folk-lab/RTA-Temperature-Controller/RTA TC diagram v2.pdf

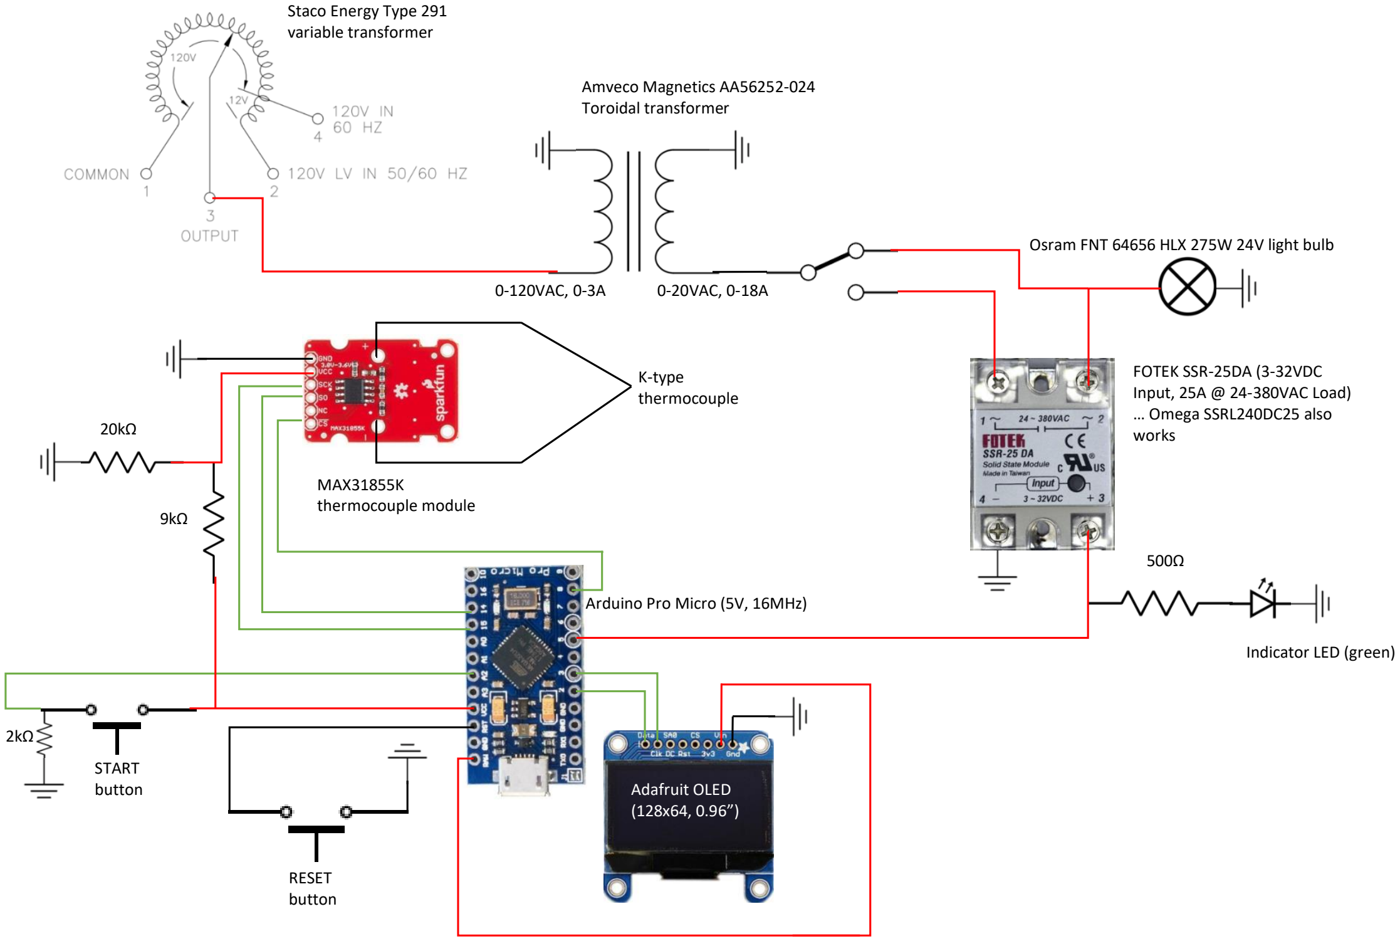
[picture p1: figure]
Indicator LED (green); 0-120VAC, 0-3A; 0-20VAC, 0-18A; START button; RESET button; Osram FNT 64656 HLX 275W 24V light bulb; K-type thermocouple; MAX31855K thermocouple module; Staco Energy Type 291 variable transformer; Amveco Magnetics AA56252-024 Toroidal transformer; Arduino Pro Micro (5V, 16MHz); FOTEK SSR-25DA (3-32VDC Input, 25A @ 24-380VAC Load) … Omega SSRL240DC25 also works; Adafruit OLED (128x64, 0.96”)
