folk-lab/RTA-Temperature-Controller/v1/RTA TC v1 diagram.pdf

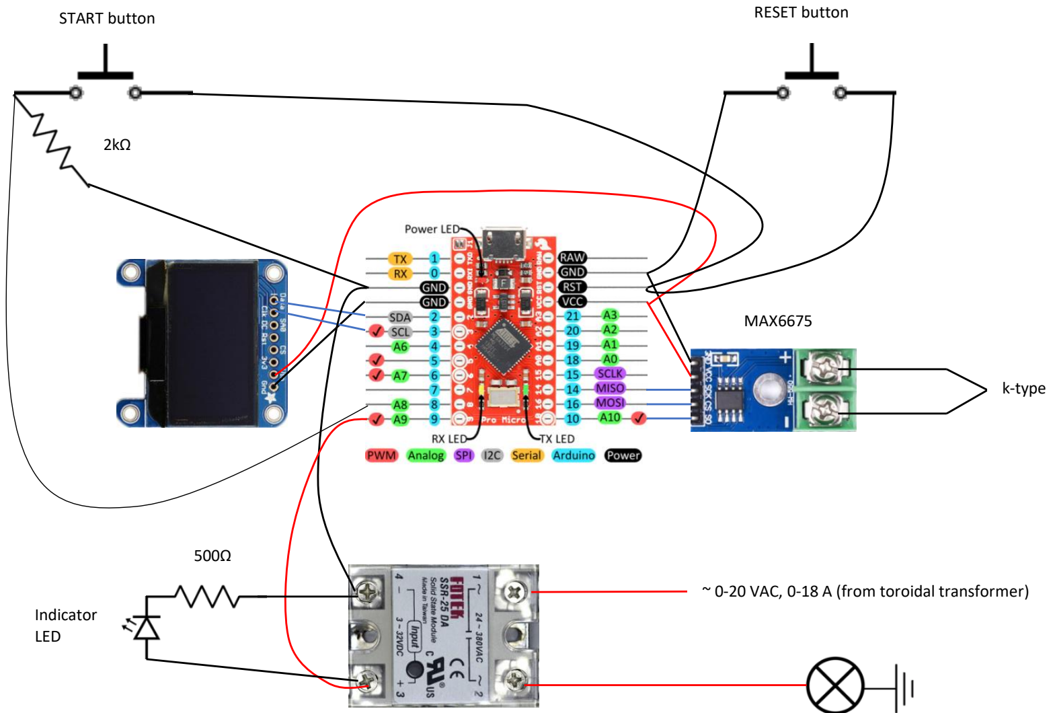
[picture p2: figure]
START button; RESET button; k-type; MAX6675; Indicator LED

~ 0-20 VAC, 0-18 A (from toroidal transformer)

Light bulb in the vacuum tube
