folk-lab/RTA-Temperature-Controller/src/Bitmap.h

const unsigned char myBitmap [] PROGMEM = {
	0x80, 0x00, 0x00, 0x00, 0x00, 0x00, 0x00, 0x07, 0xff, 0xff, 0xff, 0xff, 0xff, 0xff, 0xff, 0xf8, 
	0x00, 0x00, 0x00, 0x00, 0x00, 0x00, 0x00, 0x07, 0xff, 0xff, 0xff, 0xff, 0xff, 0xff, 0xff, 0xf8, 
	0x00, 0x00, 0x00, 0x00, 0x00, 0x00, 0x00, 0x07, 0xff, 0xff, 0xff, 0xff, 0xff, 0xff, 0xff, 0xf8, 
	0x00, 0x00, 0x00, 0x00, 0x00, 0x00, 0x00, 0x07, 0xff, 0xff, 0xff, 0xfc, 0x3f, 0xff, 0xff, 0xf8, 
	0x00, 0x00, 0x00, 0x00, 0x00, 0x00, 0x00, 0x07, 0xff, 0xff, 0xfe, 0x00, 0x07, 0xff, 0xff, 0xf8, 
	0x00, 0x00, 0x00, 0x00, 0x00, 0x00, 0x00, 0x07, 0xff, 0xff, 0xf8, 0x00, 0x03, 0xff, 0xff, 0xf8, 
	0x00, 0x00, 0x00, 0x7f, 0x80, 0x00, 0x00, 0x07, 0xff, 0xff, 0xf0, 0x00, 0x00, 0xff, 0xff, 0xf8, 
	0x00, 0x00, 0x01, 0xff, 0xc0, 0x00, 0x00, 0x07, 0xff, 0xff, 0xe0, 0x00, 0x00, 0x7f, 0xff, 0xf8, 
	0x00, 0x00, 0x03, 0xff, 0xe0, 0x00, 0x00, 0x07, 0xff, 0xff, 0xc0, 0x00, 0x00, 0x3f, 0xff, 0xf8, 
	0x00, 0x00, 0x07, 0xff, 0xf3, 0x00, 0x00, 0x07, 0xff, 0xff, 0x80, 0x00, 0x00, 0x1f, 0xff, 0xf8, 
	0x00, 0x00, 0x0f, 0xff, 0xff, 0x80, 0x00, 0x07, 0xff, 0xff, 0x80, 0x00, 0x00, 0x0f, 0xff, 0xf8, 
	0x00, 0x00, 0x0f, 0xff, 0xff, 0xc0, 0x00, 0x07, 0xff, 0xff, 0x00, 0x00, 0x00, 0x0f, 0xff, 0xf8, 
	0x00, 0x00, 0x1f, 0xff, 0xff, 0xe0, 0x00, 0x07, 0xff, 0xfe, 0x01, 0x80, 0x00, 0x07, 0xff, 0xf8, 
	0x80, 0x00, 0x1f, 0xff, 0xff, 0xf0, 0x00, 0x07, 0xff, 0xfe, 0x03, 0xfe, 0x00, 0x07, 0xff, 0xf8, 
	0x80, 0x00, 0x3f, 0xff, 0xff, 0xf0, 0x00, 0x07, 0xff, 0xfc, 0x07, 0xff, 0x00, 0x03, 0xff, 0xf8, 
	0x80, 0x00, 0x3f, 0xff, 0xff, 0xf8, 0x00, 0x07, 0xff, 0xfc, 0x0f, 0xff, 0x80, 0x03, 0xff, 0xf8, 
	0x80, 0x00, 0x3f, 0xff, 0xff, 0xf8, 0x00, 0x07, 0xff, 0xf8, 0x0f, 0xff, 0xc0, 0x01, 0xff, 0xf8, 
	0x80, 0x00, 0x3f, 0xff, 0xff, 0xf8, 0x00, 0x07, 0xff, 0xf8, 0x0f, 0xff, 0xe0, 0x01, 0xff, 0xf8, 
	0x80, 0x00, 0x3f, 0xff, 0xff, 0xf8, 0x00, 0x07, 0xff, 0xf8, 0x07, 0xff, 0xf0, 0x01, 0xff, 0xf8, 
	0x80, 0x00, 0x3f, 0xff, 0xff, 0xf8, 0x00, 0x07, 0xff, 0xf8, 0x0f, 0xff, 0xf0, 0x00, 0xff, 0xf8, 
	0x80, 0x00, 0x3f, 0xff, 0xff, 0xf8, 0x00, 0x07, 0xff, 0xf8, 0x0f, 0xfc, 0x78, 0x00, 0xff, 0xf8, 
	0x80, 0x00, 0x3f, 0xff, 0xff, 0xf8, 0x00, 0x07, 0xff, 0xf8, 0x07, 0xf0, 0xf8, 0x00, 0xff, 0xf8, 
	0x80, 0x00, 0x3f, 0xff, 0xff, 0xf8, 0x00, 0x07, 0xff, 0xf8, 0x01, 0xe0, 0xfc, 0x00, 0xff, 0xf8, 
	0x80, 0x00, 0x3f, 0xff, 0xf8, 0xf8, 0x00, 0x07, 0xff, 0xfc, 0x00, 0xf0, 0x1e, 0x00, 0x7f, 0xf8, 
	0x80, 0x00, 0x3f, 0x03, 0xf0, 0x18, 0x00, 0x07, 0xff, 0xfc, 0x00, 0xf0, 0x1f, 0x00, 0x7f, 0xf8, 
	0x80, 0x0e, 0x3e, 0x01, 0xe0, 0x08, 0x00, 0x07, 0xff, 0xfc, 0x00, 0x70, 0x1f, 0x00, 0x7f, 0xf8, 
	0x80, 0x0b, 0x3c, 0x03, 0xe0, 0x09, 0x80, 0x07, 0xff, 0xfc, 0x00, 0xf9, 0xff, 0x00, 0x3f, 0xf8, 
	0x80, 0x09, 0x3f, 0xdf, 0xfe, 0xd8, 0x00, 0x07, 0xff, 0xfc, 0x00, 0xff, 0xff, 0x00, 0x3f, 0xf8, 
	0x80, 0x0f, 0xbf, 0xff, 0xff, 0xfc, 0x00, 0x07, 0xff, 0xfc, 0x00, 0xff, 0xff, 0x00, 0x3f, 0xf8, 
	0x80, 0x0f, 0xff, 0xff, 0xff, 0xff, 0x80, 0x07, 0xff, 0xfc, 0x00, 0xff, 0xff, 0x80, 0x3f, 0xf8, 
	0x80, 0x0f, 0xff, 0xff, 0xff, 0xff, 0x80, 0x07, 0xff, 0xfe, 0x01, 0xff, 0xff, 0x80, 0x3f, 0xf8, 
	0x80, 0x07, 0xff, 0xff, 0xff, 0xfd, 0x80, 0x07, 0xff, 0xfe, 0x00, 0x8f, 0xff, 0x80, 0x3f, 0xf8, 
	0x80, 0x07, 0xff, 0xff, 0xff, 0xfd, 0x80, 0x07, 0xff, 0xfe, 0x00, 0x2f, 0xff, 0x80, 0x1f, 0xf8, 
	0x80, 0x07, 0xff, 0xff, 0xff, 0xfd, 0x00, 0x07, 0xff, 0xfe, 0x00, 0x3f, 0xff, 0x80, 0x1f, 0xf8, 
	0x80, 0x03, 0xff, 0xff, 0xff, 0xff, 0x00, 0x07, 0xff, 0xfe, 0x00, 0x3f, 0xff, 0x80, 0x1f, 0xf8, 
	0x80, 0x03, 0xff, 0xfc, 0xcf, 0xff, 0x00, 0x07, 0xff, 0xfc, 0x00, 0x0e, 0x7f, 0x00, 0x1f, 0xf8, 
	0x80, 0x03, 0xff, 0xfc, 0x07, 0xff, 0x00, 0x07, 0xff, 0xfc, 0x00, 0x00, 0x7f, 0x00, 0x0f, 0xf8, 
	0x80, 0x01, 0xff, 0xff, 0x0f, 0xfa, 0x00, 0x07, 0xff, 0xfc, 0x08, 0x1f, 0xff, 0x00, 0x0f, 0xf8, 
	0x80, 0x00, 0x3f, 0xff, 0x1f, 0xf8, 0x00, 0x07, 0xff, 0xfc, 0x0c, 0x3f, 0xff, 0x00, 0x0f, 0xf8, 
	0x80, 0x00, 0x1f, 0xff, 0xff, 0xf0, 0x00, 0x07, 0xff, 0xf8, 0x00, 0x3f, 0xfe, 0x00, 0x0f, 0xf8, 
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
};
