folk-lab/RTA-Temperature-Controller/(commit log)

2021-07-24 Set knob to 60% full power when testing - Ray
2021-07-27 Cosmetic changes. Fixed display not starting up
    [RTA_TC.ino]
2021-07-27 Added code for the start button
2021-07-27 added static temperature read
2021-07-28 Add files via upload
    Schematic of the circuit which operates the PID mode.
2021-08-06 Fixed relay opening even after sequence completion.
    [HeatingStep.h, RTA_TC_v2.ino]
2021-08-07 added silly script to read arduino data
2021-08-24 Use timer interrupt for temperature read
2021-10-01 Updated README to reflect relay response time
2022-10-17 Improve PID behaviour
    Added by Tim:
    - Added dummy calls to pid.Compute() during initial ramp up and overshoot
    This is so that the PID has a history of values as soon as we switch to relying on it.
    Seems to improve behavior, although PID params will need to be tweaked.
    [RTA-Temperature-Controller.ino]
2022-10-18 Improve analysis of PID tests
    Ran some PID tests.
    Align the temperature traces to a set temperature to compare the different PID responses better.
